Lansyfonseka/Diplom/Экономика/Пример/6.jpg

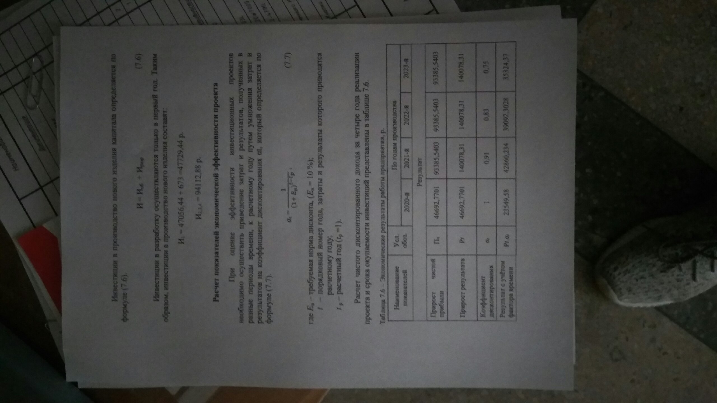
Экономика/Пример/6.jpg
