Lansyfonseka/Diplom/Экономика/Пример/3.jpg

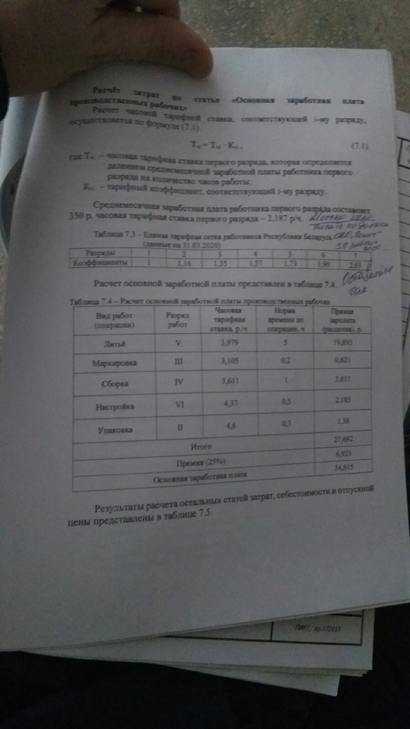
Экономика/Пример/3.jpg
