Lansyfonseka/Diplom/Практика/Конструкторы/Организационная_структура_НИИЭВМ.docx

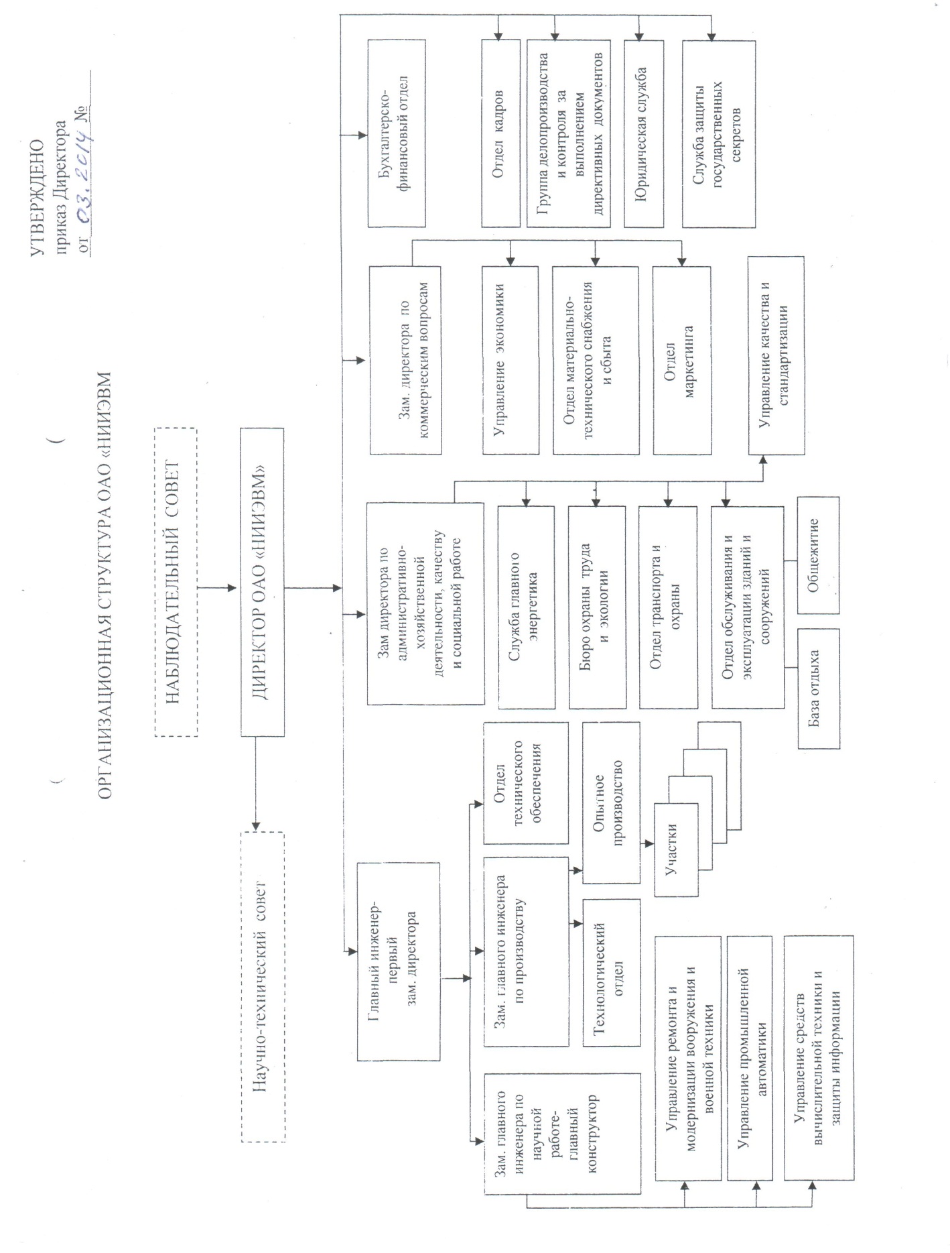
[picture p24: figure]
структура
