Lansyfonseka/Diplom/Экономика/Пример.pdf

Технико-экономическое обоснование эффективности производства стеллажного автоматического кран-штабелера с телескопическим захватным органом

1. Характеристика стеллажного автоматического кран-штабелера с телескопическим захватным органом

Одноколонный стеллажный автоматический кран-штабелер с телескопическим захватным органом является наиболее эффективным складским оборудованием и используется для автоматизации погрузочно-разгрузочных работа на складе предприятия.
Достоинствами одноколонного стеллажного кран-штабелер с вертикальной колонной, перемещающейся в проходе между стеллажами, является минимальная собственная масса и размеры, возможность более эффективно использовать высоту помещения, удобство при монтаже.
Применение одноколонного автоматического кран-штабелера позволяют рационализировать складское хозяйство, экономить площади, высвободить значительное количество вспомогательных рабочих.
Данное оборудование применяют в самых различных отраслях промышленности, но особенно эффективно – в машиностроении, металлургической промышленности, материально-техническом снабжении.
На основе маркетинговых исследований был определен спрос на новое оборудования для автоматизации складского хозяйства, прогнозируемый объем продаж в первый год составит - 50 шт., в последующие годы объем продаж увеличится исходя из потребности рынка до 100 шт.
Экономическое обоснование осуществляется в соответствии с методикой, представленной в ССЫЛКА НА ЛИТЕРАТУРУ.

### 2 Расчет стоимостной оценки результата

2.1 Расчет отпускной цены одноколонный автоматический стеллажный автоматический кран-штабелер с телескопическим захватным органом.

Для расчета отпускной цены будет использован метод сложного коэффициента качества.
В качестве базы для сравнения выбрано оборудование предприятияконкурента.
Технические характеристики оборудования представлены в таблице 2.1.

Таблица 2.1 - Технические характеристики сравниваемых кран-штабелеров

Показатель | Значение показателя
Кран-штабелер конкурента | Проектируемый кран-штабелер
1. Грузоподъемность, т | 1,0 | 1,0
2. Высота подъема грузозахватного орга-на, м | 3,8 | 4,2
3. Ширина крана-штабелера по грузоза-хватному органу, м | 2,5 | 2,2
4. Масса крана-штабелера, т | 3,2 | 3,0
5. Суммарная мощность электродвигате-лей, кВт | 13,0 | 12,0
6. Скорость передвижения груза, м/сек | 1,4 | 1,6

Расчет сложного коэффициента качества нового изделия по формуле:

∑
=

= α ·

m

i 1

н
i

К
кач | i
К | ,

где

н
чi К - частный коэффициент качества по i-му параметру нового изделия;

i

α - коэффициент весомости i-го параметра.
Для определения отпускной цены необходимо рассчитать сложный коэффициент качества (таблица 2.2).
Таблица 2.2 - Расчет сложного коэффициента качества
Показатель | Значение частного коэффи-циента качества | Коэффици-ент весомости показатели | Значение частного коэффициента каче-ства с учетом коэффициента весомости
1. Грузоподъемность, т | 1,0 | 0,2 | 0,2
2. Высота подъема грузоза-хватного органа, м | 1,105 | 0,15 | 0,16
3. Ширина крана-штабелера по грузозахватному органу, м | 1,36 | 0,15 | 0,2
4. Масса крана-штабелера, т | 1,06 | 0,1 | 0,11
5. Суммарная мощность элек- | 1,08 | 0,3 | 0,324

тродвигателей, кВт
6. Скорость передвижения гру-за, м/сек | 1,14 | 0,1 | 0,114
Сложный коэффициент качества | | | 1,108

Отпускная цена нового оборудования определяется по формуле

б

Ц
э

К
н
Ц = | · | ,

где
б

Ц - цена оборудования конкурента, ден. ед.
Отпускная цена крана-штабелера конкурента 120 млн руб. Следовательно, отпускная цена нового оборудования составит

=1,108·120000000=132960000 н

Ц

руб.

2.2 Расчет прироста чистой прибыли от реализации оборудования

На основе маркетинговых исследований и заказов потребителей был определен плановый объем реализации изделия, который составит в первый год 50 шт., в последующие годы - 100 шт.
Прибыль предприятия от реализации оборудования определяется по формуле:

НДС,
п

С

сНДС
отп

Ц

оп
р
П | = | · N - | · N -

где

сНДС
отп

Ц – отпускная цена с НДС изделия, ден. ед.;

п

С – полная себестоимость изделия, ден. ед.;
НДС – налог на добавленную стоимость, ден. ед.;
Налог на добавленную стоимость рассчитывается следующим образом:

д.с

100 Н

д.с

ВР Н
НДС
+

·
= | ,

где Нд.с – ставка налога на добавленную стоимость, (20 %).

Расчет чистой прибыли от реализации продукции представлен в таблице 2.3.

Таблица 2.34 – Расчет чистой прибыли

Показатель | Значение по годам

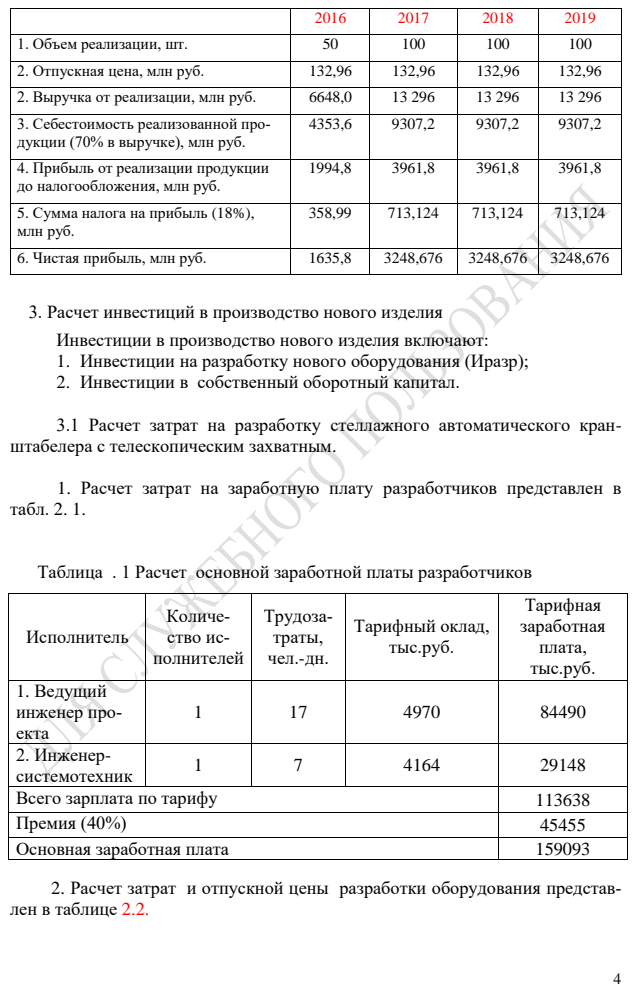
[picture p25: page 4]

1. Объем реализации, шт. | 50 | 100 | 100 | 100
2. Отпускная цена, млн руб. | 132,96 | 132,96 | 132,96 | 132,96
2. Выручка от реализации, млн руб. | 6648,0 | 13 296 | 13 296 | 13 296
3. Себестоимость реализованной про-дукции (70% в выручке), млн руб. | 4353,6 | 9307,2 | 9307,2 | 9307,2

4. Прибыль от реализации продукции до налогообложения, млн руб. | 1994,8 | 3961,8 | 3961,8 | 3961,8

5. Сумма налога на прибыль (18%), млн руб. | 358,99 | 713,124 | 713,124 | 713,124

6. Чистая прибыль, млн руб. | 1635,8 | 3248,676 | 3248,676 | 3248,676

3. Расчет инвестиций в производство нового изделия
Инвестиции в производство нового изделия включают:
1. Инвестиции на разработку нового оборудования (Иразр);
2. Инвестиции в собственный оборотный капитал.

3.1 Расчет затрат на разработку стеллажного автоматического кран-
штабелера с телескопическим захватным.

1. Расчет затрат на заработную плату разработчиков представлен в
табл. 2. 1.

Таблица . 1 Расчет основной заработной платы разработчиков

Исполнитель | Количе-ство ис-полнителей | Трудоза-траты, чел.-дн. | Тарифный оклад, тыс.руб. | Тарифная заработная плата, тыс.руб.

1. Ведущий инженер про-екта | 1 | 17 | 4970 | 84490

2. Инженер-системотехник | 1 | 7 | 4164 | 29148

Всего зарплата по тарифу | | | | 113638
Премия (40%) | | | | 45455
Основная заработная плата | | | | 159093

2. Расчет затрат и отпускной цены разработки оборудования представ-
лен в таблице 2.2.

Таблица 2.2 - Расчет затрат и отпускной цены на разработку оборудования

Наименование статьи затрат | Значение, тыс. руб. | Примечание
1.Материальные затраты | 345000
1. Основная заработная плата разработчиков | 159093 | См. табл. 2.1
2 Дополнительная зарплата | 31819 | З Н · З = 0 Д , Нд=20% Д 100
3. Отчисления на социальные нужды и обязательное стра-хование | 66056 | ( ) З + З · Н = 0 Д СОЦ , Р СОЦ 100 НСОЦ – ставка отчислений в фонд социальной защиты и обязательное страхование, 34,6%
4. Накладные расходы | 457115 | 228557,7·200 Рнакл = , Ннакл = 100 200%
5 Всего затраты на разработ-ку | 1059083 | СПР= 3428781+ 1023906+ +228557,7+ 34283,655+ +91994,47+ 457115,4
6. Плановая прибыль на еди-ницу продукции | 317725 | 5527871·15 ПЕД = , 100 Нре- норма прибыли на еди-ницу изделия, 30%
11.Отпускная цена | 1376808 | ЦОПТ=полная себестоимость + прибыль

Таким образом, инвестиции на разработку нового изделия согласно смете разработчика составляют 1 376, 808 млн руб.

3.2 Расчет инвестиций в производство нового оборудования

Производство продукции предполагается осуществлять на действующем оборудовании на свободных производственных мощностях, поэтому инвестиции в основной капитал не требуются.
Для производства нового вида продукции требуется прирост инвестиций в собственный оборотный капитал в размере 50% общей годовой потребности в материальных ресурсах.
Удельный вес материальных затрат в себестоимости оборудования составляет 50 % , следовательно, материальные затраты составят

= 4353,6 · 0,5 = 2176,8
м
Р | млн руб.

Инвестиции в прирост собственного оборотного капитала составят:

Исок = 0,5· 2176,8 = 1008,4 млн руб.

Таким образом, инвестиции в производство нового изделия составят:

И = Иразр + Исок = 1 376,8 + 1 008,4 = 2465,2 млн руб.

4. Расчет показателей экономической эффективности производства нового оборудования для складского хозяйства

При оценке эффективности инвестиционных проектов необходимо осуществить приведение затрат и результатов, полученных в разные периоды времени, к расчетному году, путем умножения затрат и результатов на коэффициент дисконтирования

αt
, который определяется следующим образом:

## ( ) P t t

н

1 Е

1
t | -
+

α =
, | (7.8)

где
н

Е - требуемая норма дисконта, 40%;
t - порядковый номер года, затраты и результаты которого приводятся к расчетному году;

р

t - расчетный год, в качестве расчетного года принимается год

вложения инвестиций,
| р

t

= 1.

Расчет чистого дисконтированного дохода за четыре года реализации проекта и срока окупаемости инвестиций представлены в таблице 7.6.

Таблица 7.6 Экономические результаты работы предприятия

Наименование показа-телей | Ед. изм. | По годам производства
2016 | 2017 | 2018 | 2019
Результат
1. Прирост чистой при-были | млн руб. | 1635,8 | 3248,676 | 3248,676 | 3248,676
2. Результат с учетом фактора времени | млн. руб. | 1635,8 | 2468,9 | 1641,5 | 1182,5

Затраты (инвестиции)
3. Инвестиции в разработку нового изделия

руб. 1 376,8

4. Инвестиции в соб-ственный оборотный капитал | млн. руб. | 1008,4 | 1008,4 | - | -
5. Общая сумма инве-стиций | млн. руб. | 2465,2 | 1008,4 | - | -
6. Инвестиции с учетом фактора времени | млн. руб. | 2465,2 | 719,9 | - | -
7. Чистый дисконтиро-ванный доход по годам (п.4 - п.6) | млн. руб. | - 829,4 | 1749 | 1641,5 | 1182,5
8. ЧДД нарастающим итогом | млн. руб. | - 829,4 | 919,6 | 2561,1 | 3743,6
9. Коэффициент дис-контирования | млн. руб. | 1,000 | 0,714 | 0,510 | 0,364

Рентабельность инвестиций в производство нового оборудования определяется по формуле

100%
З

чср

П

и

Р = | · | , | (7.9)

Среднегодовая чистой прибыли за расчетный период составляет

2845,457
4

1635,8 3248,676 3248,676 3248,676 =

+ | + | +
=
чср
П | млн руб.

Таким образом, рентабельность инвестиций в разработку и производство нового оборудования составит

100% 81%
3476,6

2845,457
= | · | =
и

Р

В результате технико-экономического обоснования инвестиций в разработку и производство одноколонного стеллажного автоматического кран-штабелера с телескопическим захватным органом были получены следующие значения показателей их эффективности:
1. Чистый дисконтированный доход за четыре года производства продукции составит 3743,6 млн.руб.
2. Все инвестиции окупаются на второй год;
3. Рентабельность инвестиций составляет 81 %.
Таким образом, производство нового вида изделия является эффективным и инвестиции в его разработку целесообразны.

Литература

1. Максимов Г.Т.Технико-экономическое обоснование дипломных проектов. Методическое пособие в 4-х частях. Часть 1.Научно-исследовательские проекта: - Мн.: БГУИР, 2003 - 44 с.
2. Носенко А. А., Грицай А. В.Технико-экономическое обоснование дипломных проектов. Методическое пособие в 4-х частях. Часть 2. Расчет эко-

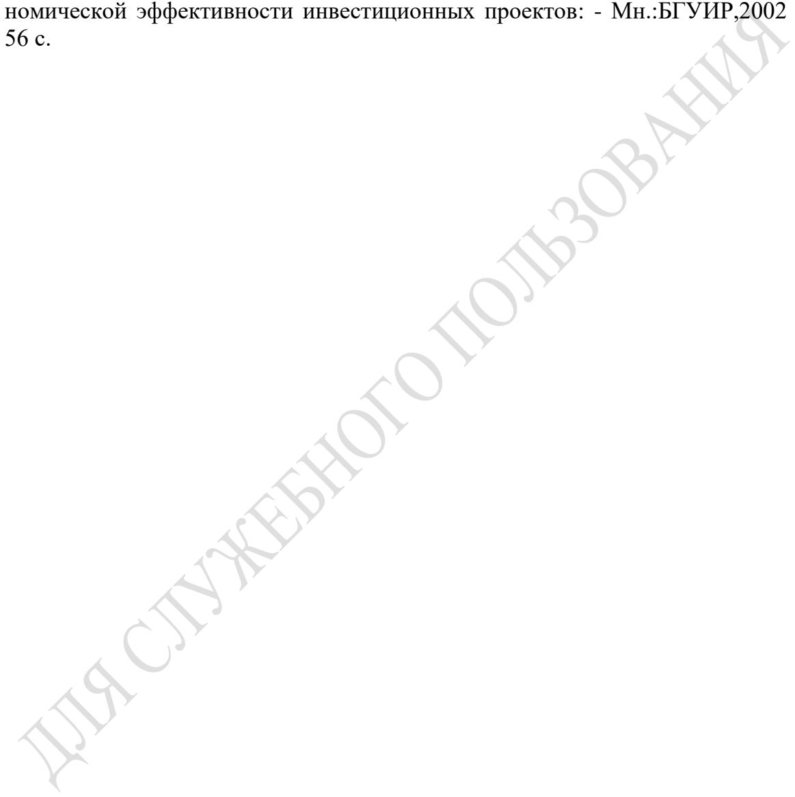
[picture p26: figure]

номической эффективности инвестиционных проектов: - Мн.:БГУИР,2002 -
