Lansyfonseka/Diplom/Экономика/Пример/1.jpg

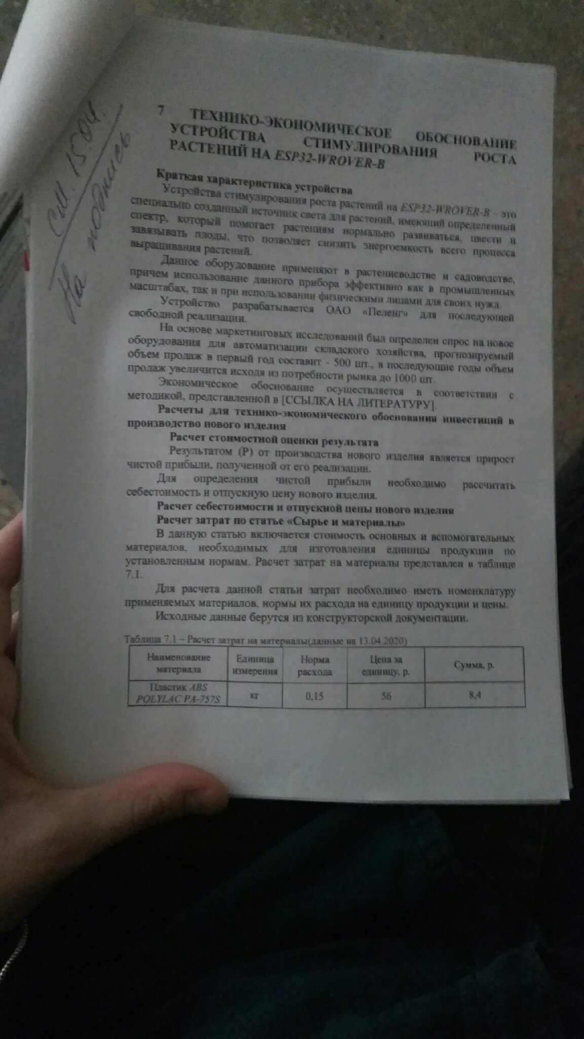
Экономика/Пример/1.jpg
