Lansyfonseka/Diplom/Экономика/Пример/2.jpg

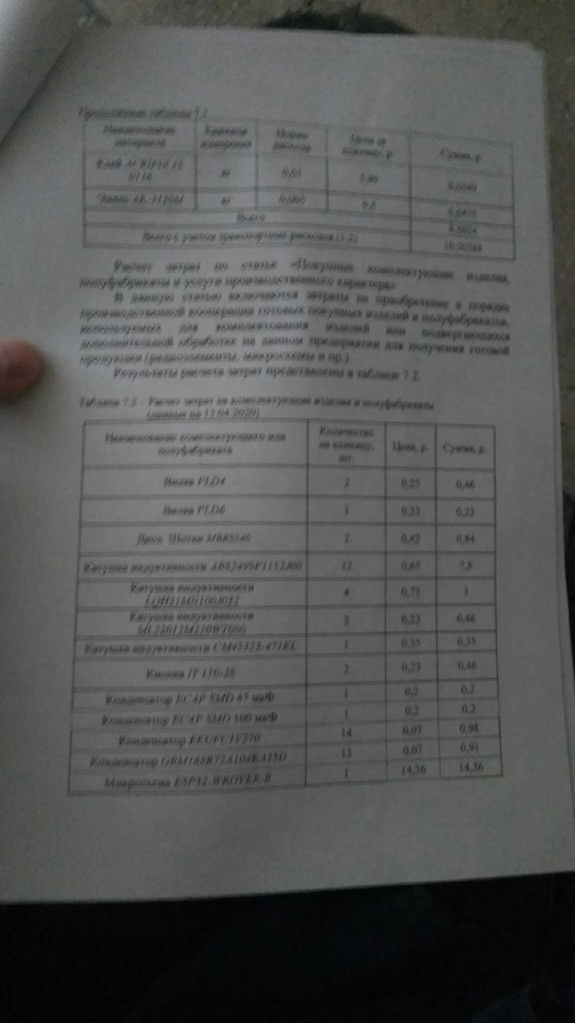
Экономика/Пример/2.jpg
