Lansyfonseka/Diplom/Экономика/Пример/4.jpg

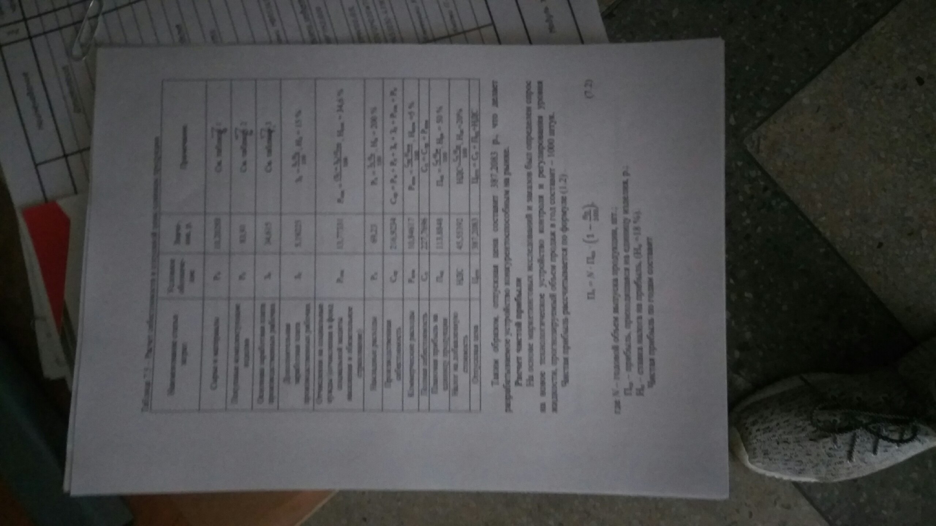
Экономика/Пример/4.jpg
