Lansyfonseka/Diplom/Экономика/Пример/7.jpg

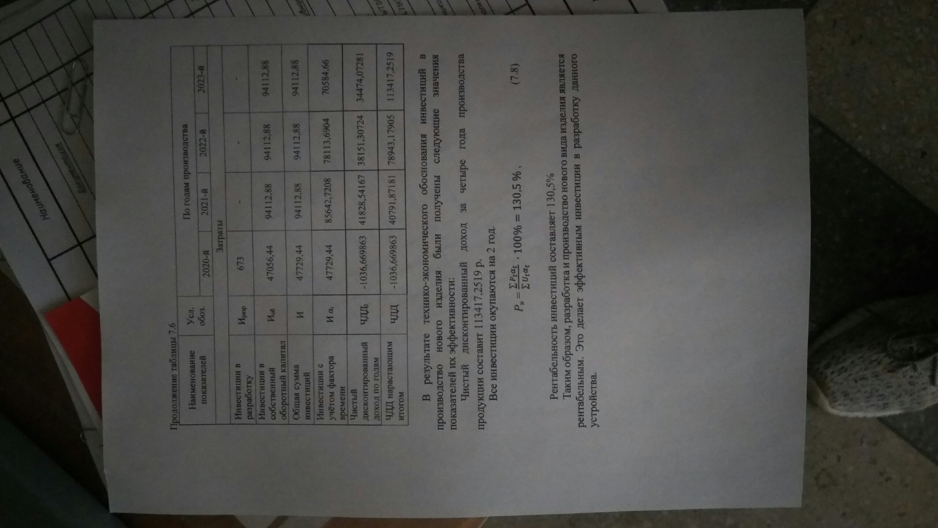
Экономика/Пример/7.jpg
