Lansyfonseka/Diplom/Экономика/Расчет.xlsx

Комплектующие | Количество, шт. | Цена, р. | Сумма, р. |  |  | Наименование материала | Единица измерения | Норма расхода | Цена за единицу, р. | Сумма, р.
Диоды HER508 | 2 | 0.14 | 0.28 |  |  | АБС Polylac PA-707 | кг | 0.5 | 5 | 2.5
Диод 1N4728A | 1 | 0.09 | 0.09 |  |  | Припой ПОС 61 ГОСТ 21931-76 (https://belchip.by/product/?selected_product=10202) | кг | 0.01 | 130 | 1.3
Диоды 1N5817 | 2 | 0.14 | 0.28 |  |  | Паяльная паста LF-4300 Amtech (https://www.chipdip.by/product/lf-4300-tf) | куб.см. | 0.3 | 4.7 | 1.41
Индикатор FYQ-3641 DH | 1 | 2.7 | 2.70 |  |  | Лак UREYAN clear (http://formodel.by/sprei_cramolin/laki_cramolin) | л | 0.02 | 60 | 1.2
SMD 0805 1мкФ | 3 | 0.08 | 0.24 |  |  | Всего |  |  |  | 6.41
SMD 0805 22мкФ | 2 | 0.08 | 0.16 |  |  | Транспортно-заготовительные расходы(10%) |  |  |  | 0.64
Электролитический SMD 150 мкФ | 1 | 0.63 | 0.63 |  |  | Всего с Транспортно-заготовительными расходами |  |  |  | 7.05
Электролитический SMD 1500 мкФ | 1 | 0.72 | 0.72 |  |  | Отходы возвратные 1% |  |  |  | 0.07
Электролитический SMD 47 мкФ | 2 | 0.2 | 0.40
Электролитический SMD 220 мкФ | 1 | 0.23 | 0.23
Микросхема TL431ACP | 1 | 0.85 | 0.85
Микросхема XC6206P33MR | 1 | 0.56 | 0.56
Микросхема LM358N | 1 | 0.24 | 0.24
Микросхема PIC16F873A-I/SP | 1 | 9.7 | 9.70
Разъем PLS-2(DS1021-1x2) | 1 | 0.18 | 0.18
Разъем BLS-2(DS1071-1x2) | 1 | 0.18 | 0.18 |  |  | Общая трудоемкость изготовления, ч | 2 |  | Часовая тарифная ставка первого разряда | 1.8
Разъем L-KLS1-233-0-0-1-T | 1 | 0.38 | 0.38
Разъем XY300VA-5.0-2P-12 | 1 | 0.42 | 0.42 |  |  | Вид работы (операция) | Разряд работ | Распределение трудоемксоти по видам работ | Тарифный коэффициент | Часовая тарифная ставка, р./ч | Норма времени по операции, ч | Прямая зарплата, р
Резисторы С2-23 2Вт 2 Ом ± 1% | 1 | 0.1 | 0.10 |  |  | Заготовительные | 2 | 10 | 1.16 | 2.088 | 0.2 | 0.42
Резисторы С2-23 2Вт 5,6 Ом ± 5% | 1 | 0.1 | 0.10 |  |  | Монтажная | 6 | 30 | 1.9 | 3.42 | 0.6 | 2.05
Резисторы С2-23 2Вт 100 Ом ± 5% | 1 | 0.05 | 0.05 |  |  | Сборочные | 6 | 20 | 1.9 | 3.42 | 0.4 | 1.37
Резисторы С2-23 2Вт 680 Ом ± 5% | 1 | 0.1 | 0.10 |  |  | Контрольные | 8 | 40 | 2.17 | 3.906 | 0.8 | 3.12
Резисторы SMD 0805 1 кОм ± 1% | 1 | 0.04 | 0.04 |  |  | Итого |  |  |  |  |  | 6.96
Резисторы SMD 0805 3 кОм ± 1% | 1 | 0.04 | 0.04 |  |  | Премия (15%) |  |  |  |  |  | 1.04
Резисторы SMD 0805 24 кОм ± 1% | 1 | 0.04 | 0.04 |  |  | Основная заработная плата |  |  |  |  |  | 8.01
Резисторы SMD 0805 30 кОм ± 1% | 1 | 0.04 | 0.04
Резисторы SMD 0805 33 кОм ± 1% | 1 | 0.04 | 0.04
Резисторы SMD 0805 75 Ом ± 5% | 1 | 0.04 | 0.04
Резисторы SMD 0805 180 Ом ± 5% | 1 | 0.04 | 0.04 |  |  | Наименование статьи затрат | Условное обозначение | Знацение, р. | Примечание
Резисторы SMD 0805 220 Ом ± 5% | 1 | 0.04 | 0.04 |  |  | Сырье и материалы | Рм | 6.98
Резисторы SMD 0805 300 Ом ± 5% | 1 | 0.04 | 0.04 |  |  | Покупные комплектующие изделия | Рк | 31.79
Резисторы SMD 0805 470 Ом ± 5% | 1 | 0.04 | 0.04 |  |  | Основная заработная плата производственных рабочих | Зо | 8.01
Резисторы SMD 0805 1 кОм ± 5% | 4 | 0.04 | 0.16 |  |  | Дополнительная заработная плата производственных рабочих | Зд | 1.20
Резисторы SMD 0805 4,7 кОм ± 5% | 2 | 0.04 | 0.08 |  |  | Отчисления на социальные нужды | Рсоц | 3.19
Резисторы SMD 0805 10 кОм ± 5% | 1 | 0.04 | 0.04 |  |  | Накладные расходы | Рн | 12.01
Резисторы SMD 0805 2 МОм ± 5% | 1 | 0.04 | 0.04 |  |  | Производственная себестоимость | Спр | 63.18
Резистор SQP 3,3 Ом 5W ± 5% | 1 | 0.38 | 0.38 |  |  | Коммерческие расходы | Рком | 1.90
Кварцевый резонатор HC-49SM | 1 | 0.42 | 0.42 |  |  | Полная себестоимость | Сп | 65.07
Транзисторы AO3401 | 2 | 0.04 | 0.08 |  |  | Плановая прибыль на единицу продукции | Пед | 26.03
Транзистор IRF7413 | 1 | 0.16 | 0.16 |  |  | Отпускная цена | Цотп | 109.32
Элемент питания LP502035 | 1 | 5 | 5.00
Стеклотекстолит фольгированный СФ2-35-1,5 | 1 | 3.26 | 3.26
Саморез М3х6 | 4 | 0.07 | 0.28
Шайба м3 | 4 | 0.003 | 0.01 |  |  | Чистая прибыть | Пч | 21343.55
Всего |  |  | 28.90 |  |  |  |  | 10671.77
Транспортно-заготовительные расходы(10%) |  |  | 2.89
Всего с Транспортно-заготовительными расходами |  |  | 31.79 |  |  | Годовая потребность в материалах | Пм | 6980.49 | 3490.25
 |  |  |  |  |  | Годовая потребность в комплектующих изделиях | Пк | 31792.2 | 15896.1
 |  | 1 | 2 | 3 | 4
Наименование показателей | Усл. Обозначение | 1-й год | 2-й год | 3-й год | 4-й год
Результат
Прирост чистой прибыли | Пч | 10671.77 | 21343.55 | 21343.55 | 21343.55
Прирост резульата | Рt | 10671.77 | 21343.55 | 21343.55 | 21343.55
коэффициент дисконтирования | At | 1.00 | 0.91 | 0.83 | 0.75
Результат с учетом фактроа времени | РtАt | 10671.77 | 19403.22 | 17639.29 | 16035.72
Затраты (инвестиции)
Инвестиции в разработку нового изделия | Иразр | 3253.59 | 0.00 | 0.00 | 0.00
Инвестиции в собственный оборотный капитал | Иоб | 7754.54 | 15509.08 | 15509.08 | 15509.08
Общая сумма инвестиций | И | 11008.13 | 15509.08 | 15509.08 | 15509.08
Инвестиции с учетом фактора времени | ИtAt | 11008.13 | 14099.16 | 12817.42 | 11652.20
Чистыый дисконтированный доход по годам | ЧДДt | -336.35 | 5304.06 | 4821.88 | 4383.52
ЧДД нарастающим итогом | ЧДД | -336.35 | 4967.71 | 9789.59 | 14173.11
Рентабильность инвестиций | Ри | 128.59
