Lansyfonseka/Diplom/Solid/Сборка1.SLDASM

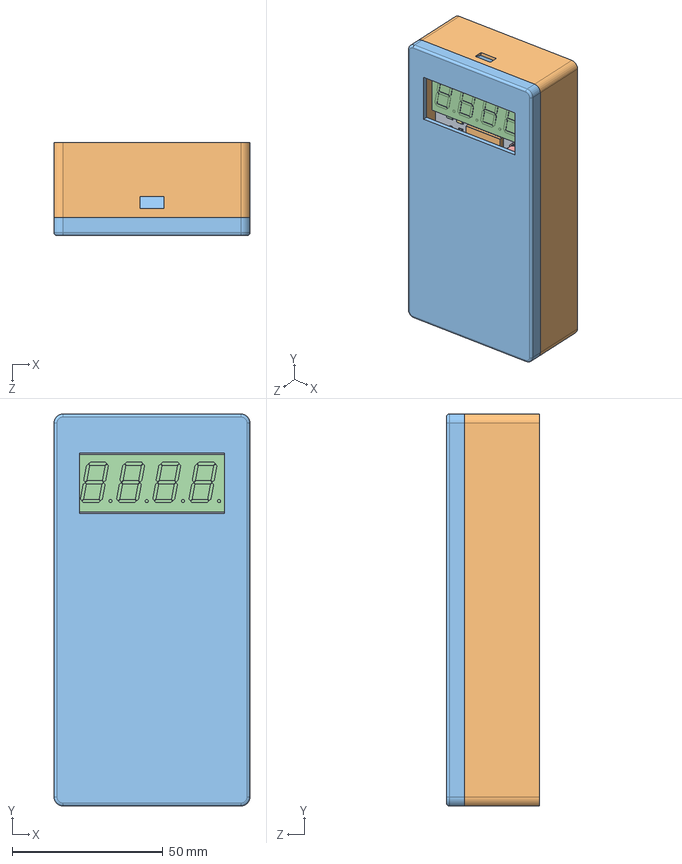
[picture p31: CAD file, 2020-04-18]
Solid/Сборка1.SLDASM
65.0 x 130.0 x 31.0 mm
Board
Open_CASCADE_STEP_translator_6.8_127.1.1 x 5
Open_CASCADE_STEP_translator_6.8_127.1.2 x 5
Open_CASCADE_STEP_translator_6.8_127.2.1 x 5
Capacitor x 3
Open_CASCADE_STEP_translator_6.8_127.1.1_2
Open_CASCADE_STEP_translator_6.8_127.1.2_2
Open_CASCADE_STEP_translator_6.8_127.2.1_2
Open_CASCADE_STEP_translator_6.8_127.1.1_3
Open_CASCADE_STEP_translator_6.8_127.1.2_3
Open_CASCADE_STEP_translator_6.8_127.2.1_3
Open_CASCADE_STEP_translator_6.8_6.1.1
Leader x 3
Open_CASCADE_STEP_translator_6.8_9.1
Open_CASCADE_STEP_translator_6.8_9.2.1
Leader_2 x 8
Open_CASCADE_STEP_translator_6.8_2.1
Open_CASCADE_STEP_translator_6.8_2.2.1
Leader_3 x 28
Indicator
Res_2W x 3
Res_5W
Mid_Body x 3
Open_CASCADE_STEP_translator_6.8_5.2.1 x 6
Mark x 3
Mid_Body_2 x 9
Open_CASCADE_STEP_translator_6.8_5.2.1_2 x 18
Mark_2 x 9
Mid_Body_3 x 5
Open_CASCADE_STEP_translator_6.8_5.2.1_3 x 10
Mark_3 x 5
Res_1W
Mid_Body_4
Open_CASCADE_STEP_translator_6.8_5.2.1_4 x 2
Mark_4
HER508 x 2
1N4728A
Diod x 2
Open_CASCADE_STEP_translator_6.8_9.1.1 x 2
Leader_4 x 6
Open_CASCADE_STEP_translator_6.8_14.1
Open_CASCADE_STEP_translator_6.8_14.2.1
Leader_5 x 8
KLS2_V2
Resonator
Open_CASCADE_STEP_translator_6.8_7.1.1
Leader_6 x 3
PIN_2
MicroUSB
Корпус
Крышка
SC GOST 17473_gost x 4
Washer 10450_2_gost x 4
