Lansyfonseka/Diplom/Solid/Крышка.SLDPRT

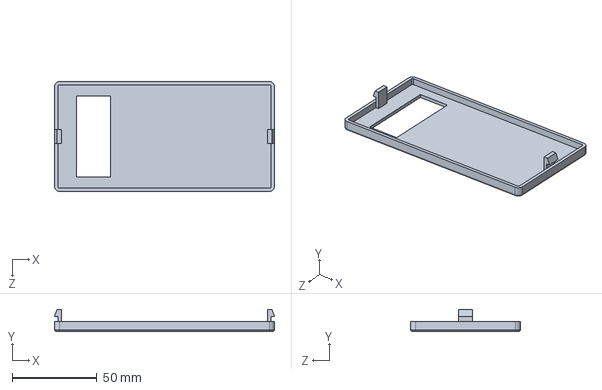
[picture p33: CAD file, 2020-04-18]
Solid/Крышка.SLDPRT
130.0 x 13.0 x 65.0 mm
