Lansyfonseka/Diplom/Solid/Шайба М2 — копия.SLDPRT

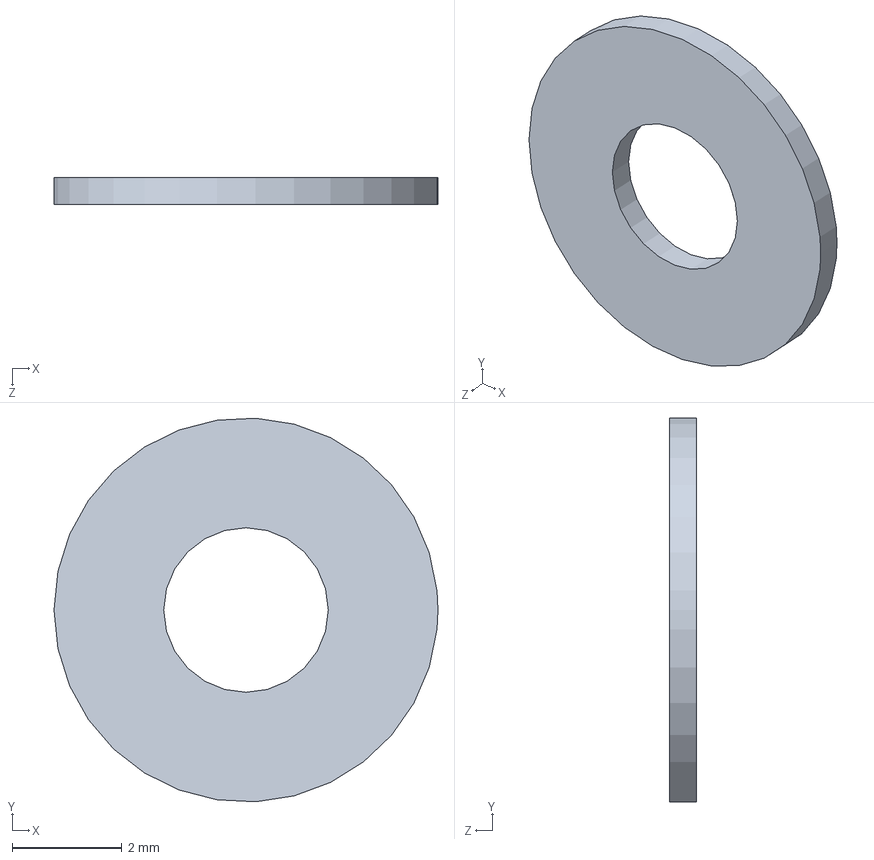
[picture p34: CAD file, 2020-04-18]
Solid/Шайба М2 — копия.SLDPRT
7.00 x 6.99 x 0.5 mm
