Lansyfonseka/Diplom/Solid/Корпус.SLDPRT

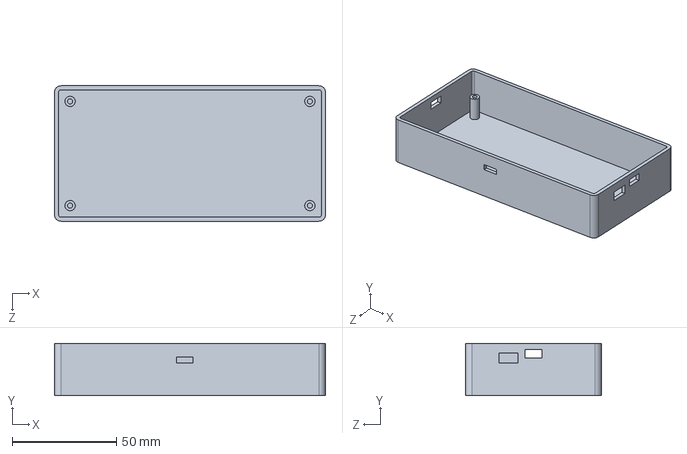
[picture p35: CAD file, 2020-04-18]
Solid/Корпус.SLDPRT
130.0 x 25.0 x 65.0 mm
