Lansyfonseka/Diplom/Solid/vintik.SLDPRT

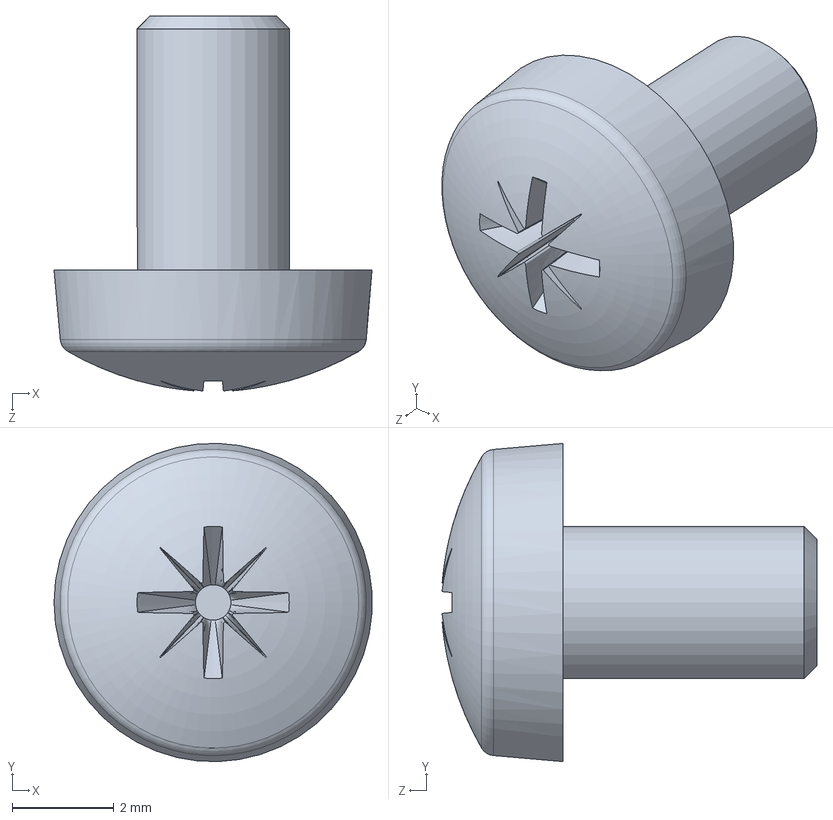
[picture p36: CAD file, 2020-04-18]
Solid/vintik.SLDPRT
6.26 x 6.26 x 7.37 mm
