Lansyfonseka/Diplom/(list of files, cad)

Other CAD files:
Solid/Plata/R8.sldasm
Solid/Plata/VD4.sldasm
Solid/Plata/DD1.sldasm
Solid/Plata/R23.sldasm
Solid/Plata/ZQ1.sldasm
Solid/Plata/XS1.sldasm
Solid/Plata/C2.sldasm
Solid/Plata/VT3.sldasm
Solid/Plata/Body_2.sldasm
Solid/Plata/VD5.sldasm
Solid/Plata/Body_4.sldasm
Solid/Plata/R2.sldasm
Solid/Plata/R6.sldasm
Solid/Plata/R14.sldasm
Solid/Plata/Body_6.sldasm
Solid/Plata/C8.sldasm
Solid/Plata/C7.sldasm
Solid/Plata/HG1.sldasm
Solid/Plata/Terminal_3.sldasm
Solid/Plata/Terminal_7.sldasm
Solid/Plata/Terminal_2.sldasm
Solid/Plata/Body.sldasm
Solid/Plata/R9.sldasm
Solid/Plata/R15.sldasm
Solid/Plata/R16.sldasm
Solid/Plata/VD1.sldasm
Solid/Plata/C1.sldasm
Solid/Plata/Mid_Body.sldasm
Solid/Plata/R17.sldasm
Solid/Plata/R5.sldasm
Solid/Plata/C3.sldasm
Solid/Plata/R3.sldasm
Solid/Plata/R19.sldasm
Solid/Plata/R21.sldasm
Solid/Plata/Terminal_4.sldasm
Solid/Plata/XT1.sldasm
Solid/Plata/DA2.sldasm
Solid/Plata/DA1.sldasm
Solid/Plata/Terminal_5.sldasm
Solid/Plata/Body_5.sldasm
Solid/Plata/R13.sldasm
Solid/Plata/Mid_Body_3.sldasm
Solid/Plata/R4.sldasm
Solid/Plata/C4.sldasm
Solid/Plata/Body_3.sldasm
Solid/Plata/Mid_Body_2.sldasm
Solid/Plata/VT1.sldasm
Solid/Plata/Terminal_6.sldasm
Solid/Plata/C5.sldasm
Solid/Plata/R1.sldasm
Solid/Plata/PCB1_2.SLDASM
Solid/Plata/C6.sldasm
Solid/Plata/Terminal.sldasm
Solid/Plata/X1.sldasm
Solid/Plata/R11.sldasm
Solid/Plata/VD3.sldasm
Solid/Plata/R18.sldasm
Solid/Plata/DA3.sldasm
Solid/Plata/R22.sldasm
Solid/Plata/R12.sldasm
Solid/Plata/R7.sldasm
Solid/Plata/R10.sldasm
Solid/Plata/C9.sldasm
Solid/Plata/R20.sldasm
Solid/Plata/C10.sldasm
Solid/Plata/VD2.sldasm
Solid/Plata/VT2.sldasm
A2.dwg
Solid/Plata/Leader_2.sldprt
Чертежи/Sbor_Plata.dwg
Шаблоны/ramka-a1-autocad-skachat.dwg
ramka_a4_gorizontal.dwg
Solid/Plata/Open_CASCADE_STEP_translator_6.8_9.1.1.sldprt
Чертежи/Scheme.dwg
Чертежи/Sturturka.dwg
Solid/Plata/Board.sldprt
Чертежи/Shelcograph.dwg
Solid/Plata/Open_CASCADE_STEP_translator_6.8_127.1.1_2.sldprt
Solid/Plata/Open_CASCADE_STEP_translator_6.8_14.1.sldprt
Solid/Plata/Open_CASCADE_STEP_translator_6.8_127.2.1_3.sldprt
Solid/Plata/Open_CASCADE_STEP_translator_6.8_127.1.1_3.sldprt
Solid/Plata/Open_CASCADE_STEP_translator_6.8_9.2.1.sldprt
Solid/Plata/Open_CASCADE_STEP_translator_6.8_5.2.1.sldprt
Solid/Plata/Open_CASCADE_STEP_translator_6.8_7.1.1.sldprt
Solid/Plata/Mark_3.sldprt
Solid/Plata/Indicator.sldprt
Solid/Plata/Open_CASCADE_STEP_translator_6.8_127.2.1_2.sldprt
Solid/Plata/Open_CASCADE_STEP_translator_6.8_127.1.2_2.sldprt
Solid/Plata/KLS2_V2.sldprt
Solid/Plata/Leader_4.sldprt
Solid/Plata/PIN_2.sldprt
Solid/Plata/Open_CASCADE_STEP_translator_6.8_6.1.1.sldprt
Solid/Plata/Mark_2.sldprt
Solid/Plata/Leader_6.sldprt
Solid/Plata/Leader_3.sldprt
Solid/Plata/Open_CASCADE_STEP_translator_6.8_5.2.1_3.sldprt
Solid/Plata/Open_CASCADE_STEP_translator_6.8_5.2.1_2.sldprt
Solid/Plata/Open_CASCADE_STEP_translator_6.8_127.1.1.sldprt
Solid/Plata/Mark.sldprt
Solid/Plata/Open_CASCADE_STEP_translator_6.8_5.2.1_4.sldprt
Solid/Plata/Leader.sldprt
Solid/Plata/Res_1W.sldprt
Solid/Plata/Open_CASCADE_STEP_translator_6.8_127.1.2.sldprt
Solid/Plata/Open_CASCADE_STEP_translator_6.8_14.2.1.sldprt
Solid/Plata/HER508.sldprt
Solid/Plata/Res_5W.sldprt
Solid/Plata/1N4728A.sldprt
Solid/Plata/Diod.sldprt
Solid/Plata/Capacitor.sldprt
Solid/Plata/Open_CASCADE_STEP_translator_6.8_127.1.2_3.sldprt
Solid/Plata/MicroUSB.sldprt
Solid/Plata/Open_CASCADE_STEP_translator_6.8_2.1.sldprt
Solid/Plata/Mid_Body_4.sldprt
Solid/Plata/Mark_4.sldprt
Solid/Plata/Open_CASCADE_STEP_translator_6.8_2.2.1.sldprt
Solid/Plata/Open_CASCADE_STEP_translator_6.8_127.2.1.sldprt
Solid/Plata/Leader_5.sldprt
Solid/Plata/Open_CASCADE_STEP_translator_6.8_9.1.sldprt
Solid/Plata/Res_2W.sldprt
Solid/Plata/Resonator.sldprt
Solid/Plata/1000307696.sldasm
Solid/Plata/1000344048.sldasm
Solid/Plata/1000345840.sldasm
Solid/Plata/1000345968.sldasm
Solid/Plata/1000346096.sldasm
Solid/Plata/1000346224.sldasm
Solid/Plata/1000346352.sldasm
Solid/Plata/1000346480.sldasm
Solid/Plata/1000346608.sldasm
Solid/Plata/1000346736.sldasm
Solid/Plata/1000346864.sldasm
Solid/Plata/1000346992.sldasm
Solid/Plata/1000347248.sldasm
Solid/Plata/Mid_Body.sldprt
Solid/Plata/Mid_Body_2.sldprt
Solid/Plata/Mid_Body_3.sldprt
Solid/Корпус.SLDDRW
Solid/Сборка1.SLDDRW
