Lansyfonseka/Diplom/Чертежи/PDF/Sbor_Plata.pdf

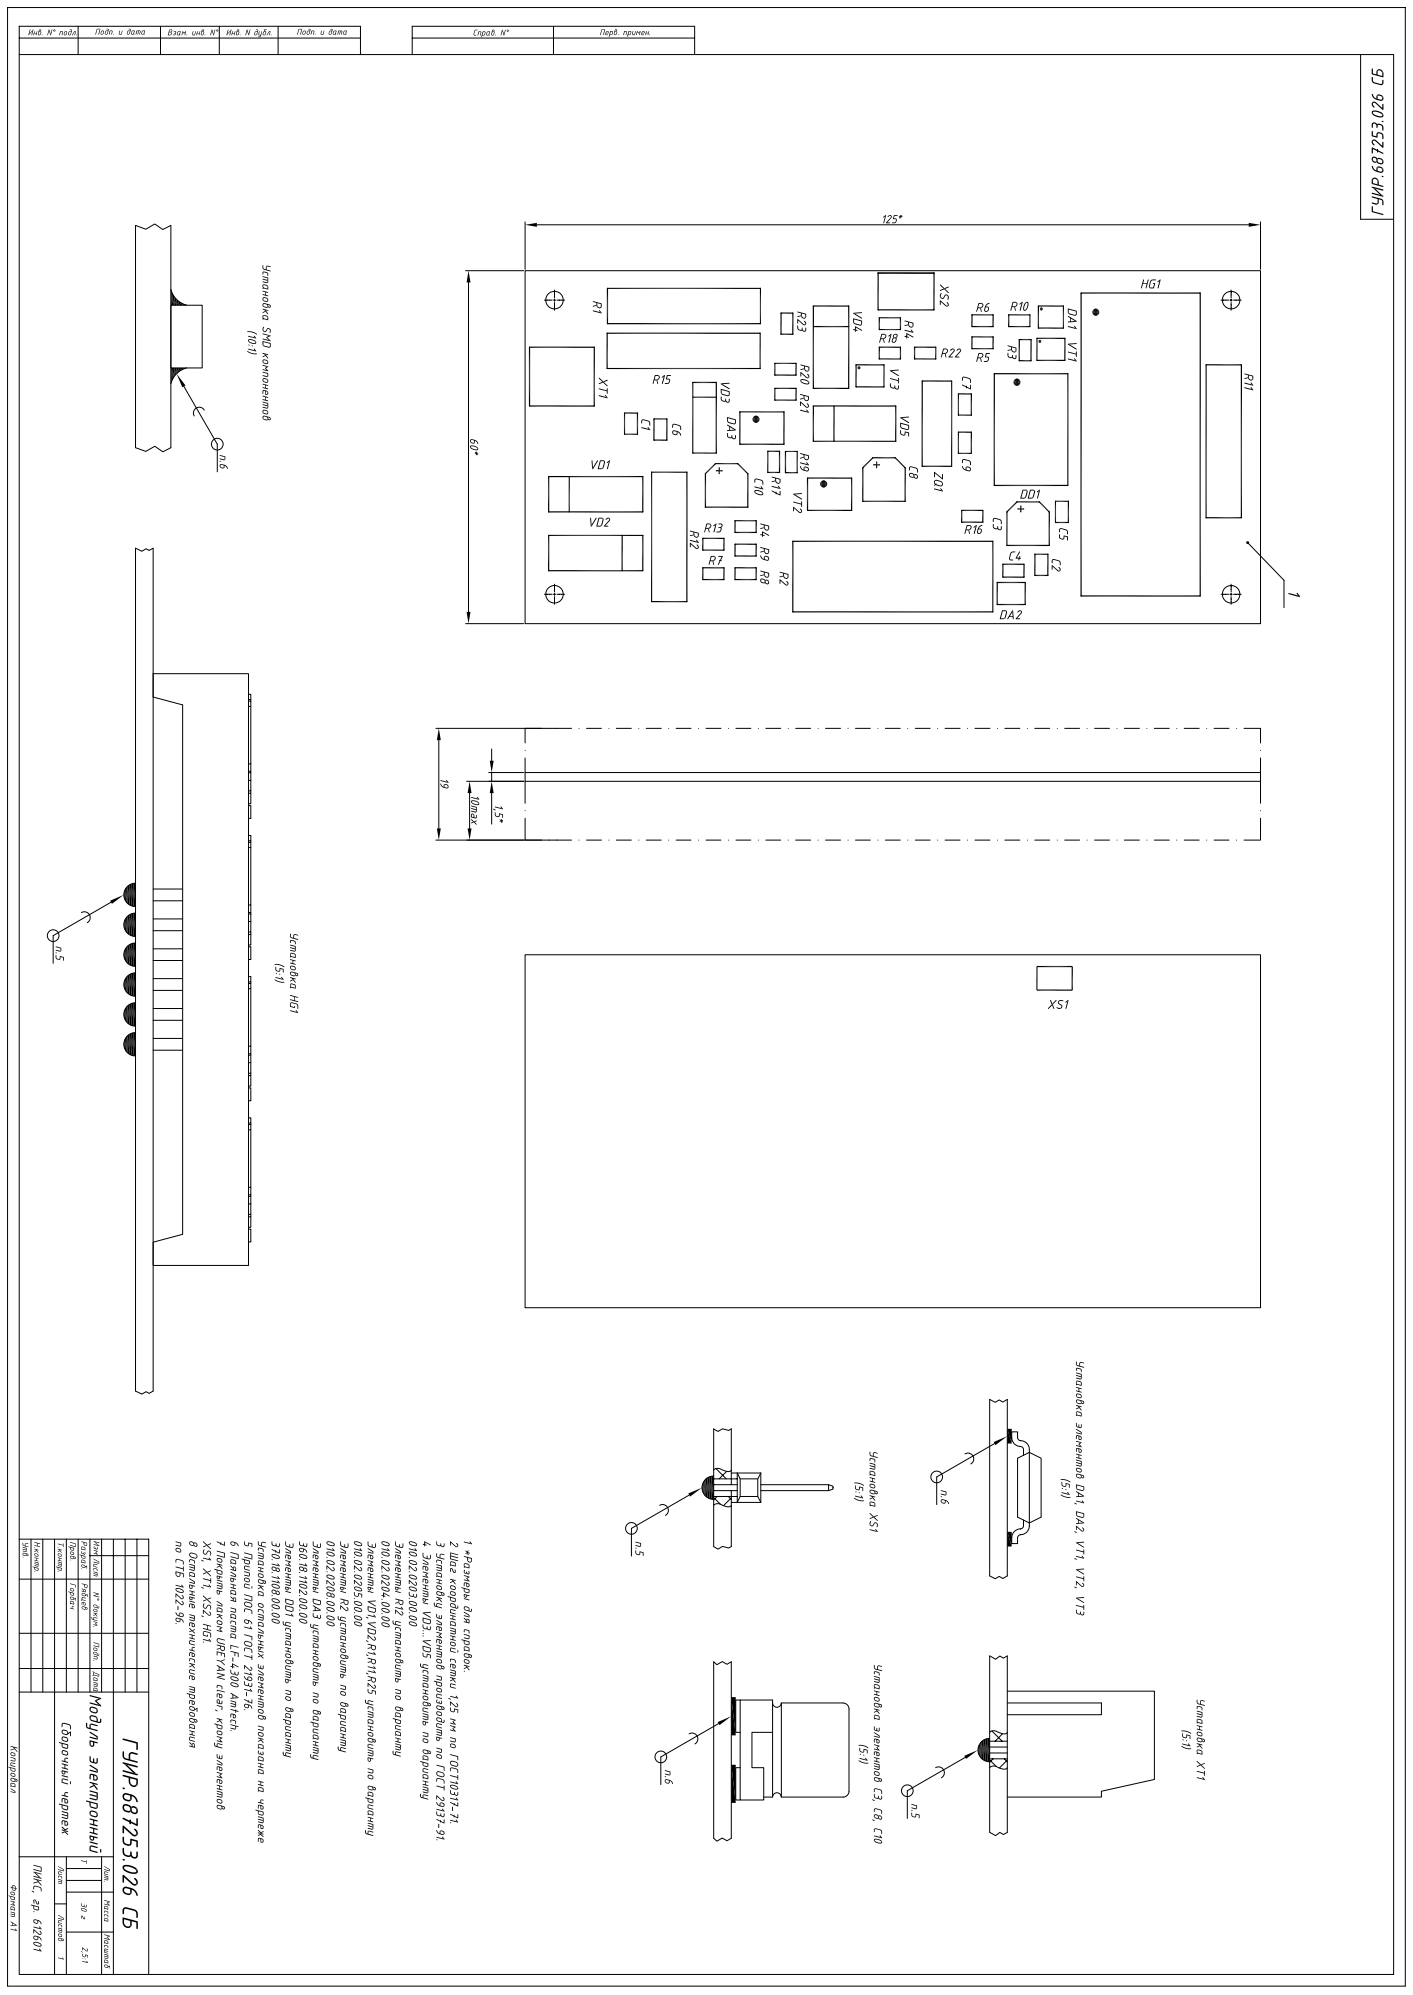
[picture p37: page 1]
