Lansyfonseka/Diplom/Чертежи/PDF/Shelcograph.pdf

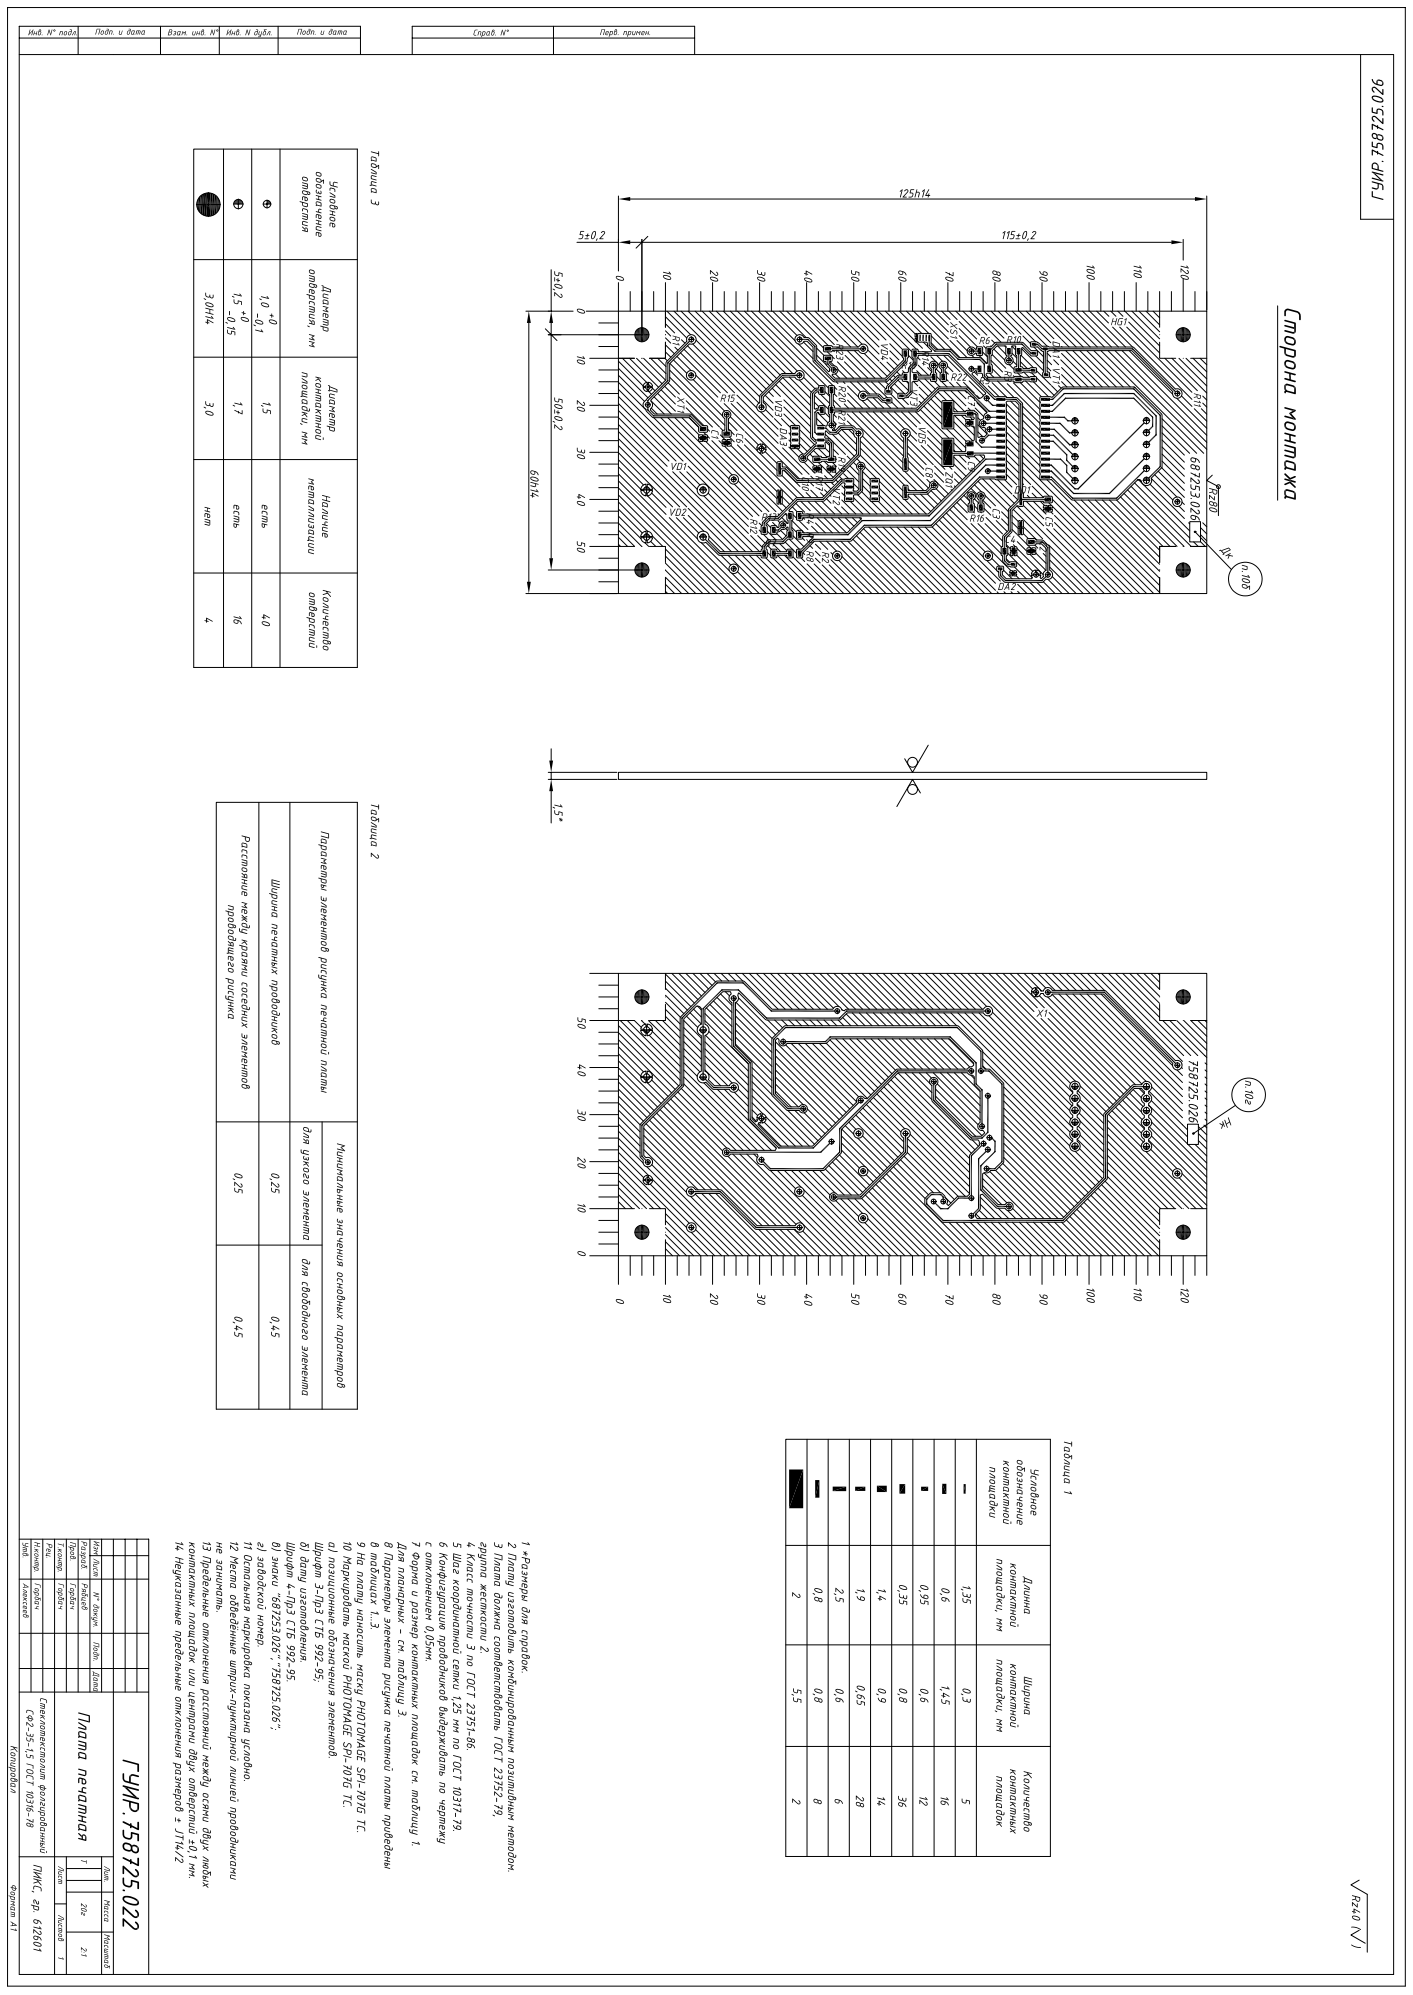
[picture p38: page 1]
