Lansyfonseka/Diplom/Чертежи/PDF/Сборка1.pdf

В

A

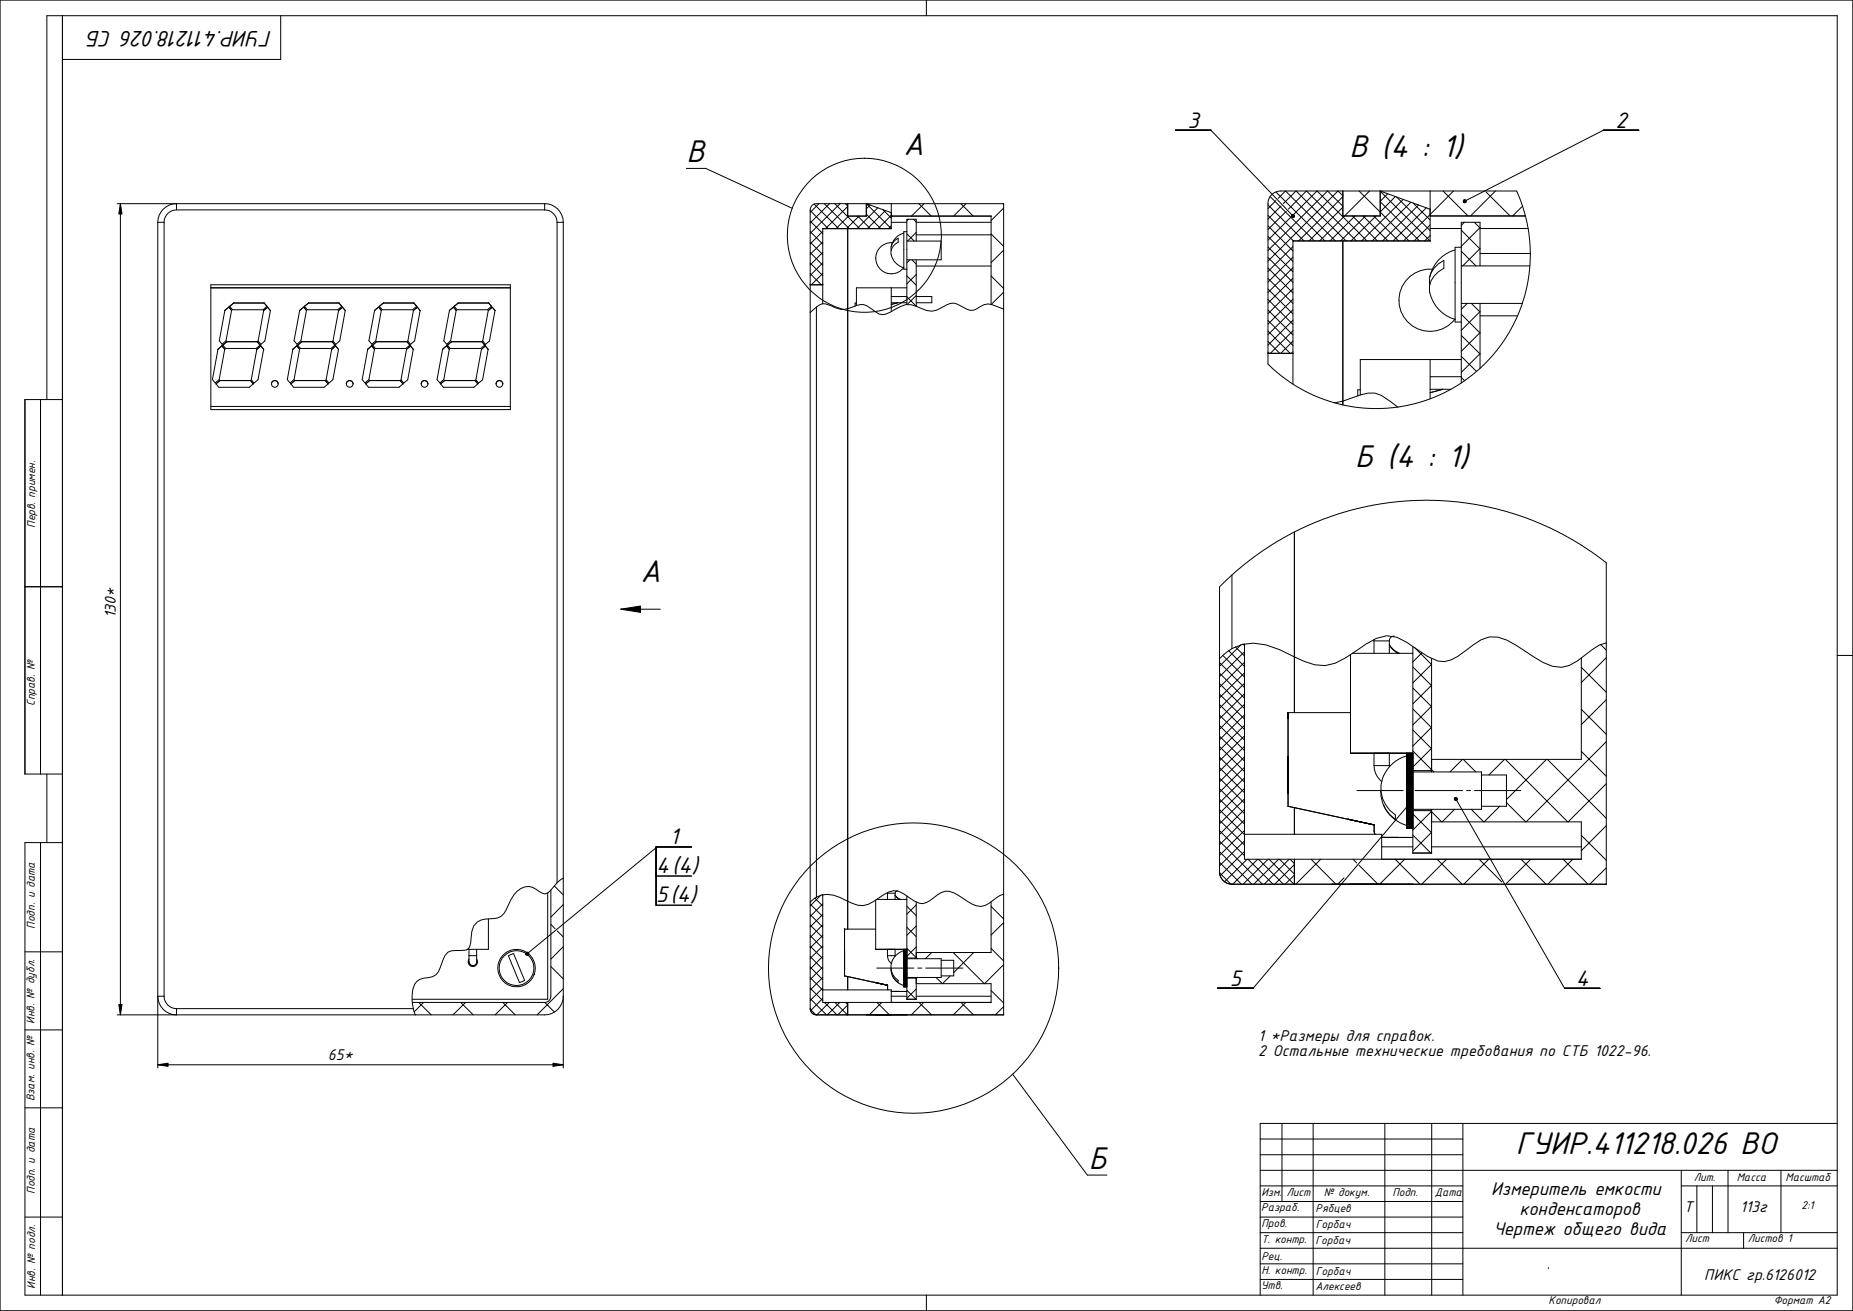
[picture p40: page 1]
Копировал; Формат А2

Справ. № Перв. примен. Подп. и дата Инв. № дубл. Взам. инв. № Подп. и дата Инв. № подл. ПИКС гр.6126012

1 *Размеры для справок.
2 Остальные технические требования по СТБ 1022-96.

ГУИР.411218.026 ВО

Измеритель емкости конденсаторов Чертеж общего вида | Лит. | Масса | Масштаб

Изм. | Лист | № докум. | Подп. | Дата | | T | | | 113г | 2:1
Разраб. | | Рябцев
Пров. | | Горбач
Т. контр. | Горбач | | | | Лист | Листов 1
Рец.
Н. контр. | Горбач
Утв. | Алексеев
