Lansyfonseka/Diplom/Чертежи/PDF/Структурная+принципиальная.pdf

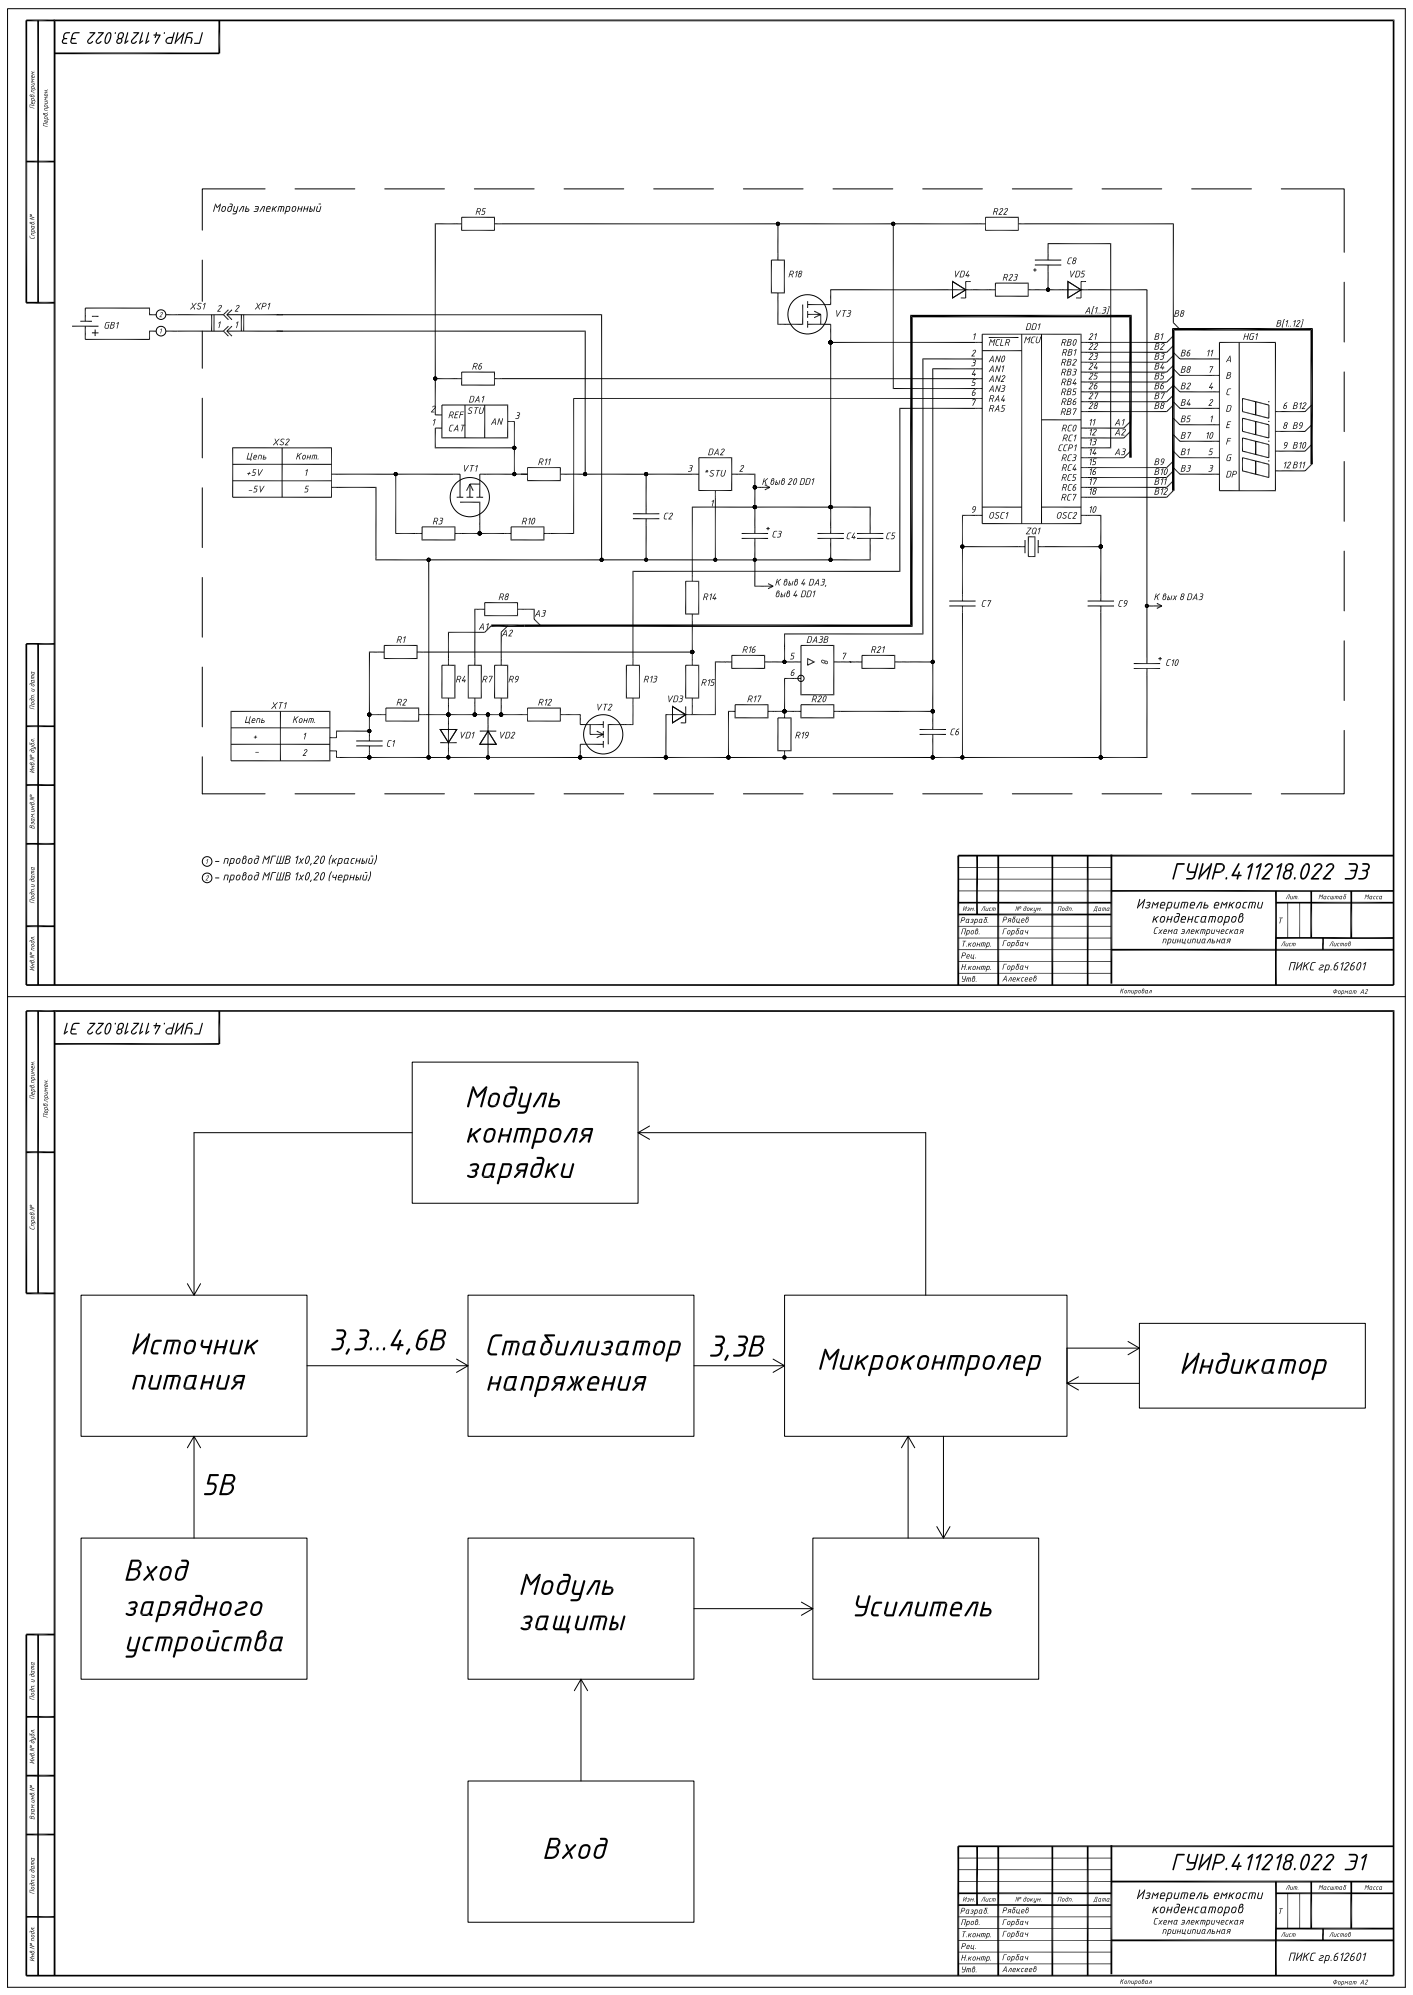
[picture p41: page 1]
