Lansyfonseka/Diplom/(list of files, drawings)

Other design files:
Altium/PCB1.PcbDoc
Altium/PCB_Project.PrjPcb
Altium/PcbLib1.PcbLib
Altium/Schlib1.SchLib
